jewing18/Automated-Chicken-Coop-wifi-enabled/Setup, Info/Example of Door Motor.png

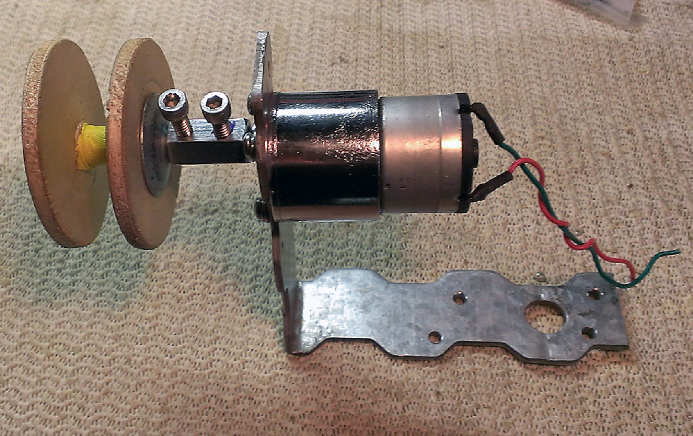
Setup, Info/Example of Door Motor.png
