jewing18/Automated-Chicken-Coop-wifi-enabled/Setup, Info/Wiring Diagram.png

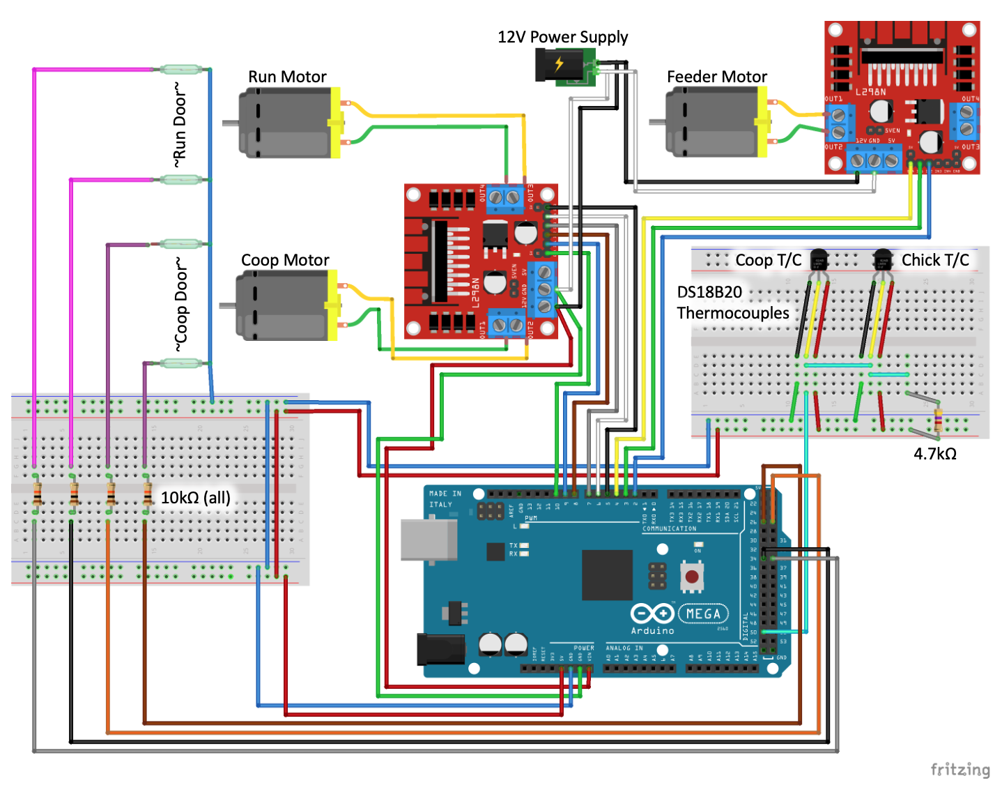
Setup, Info/Wiring Diagram.png
