jewing18/Automated-Chicken-Coop-wifi-enabled/STLs/Door Motor Mounts_REV00 v1.step

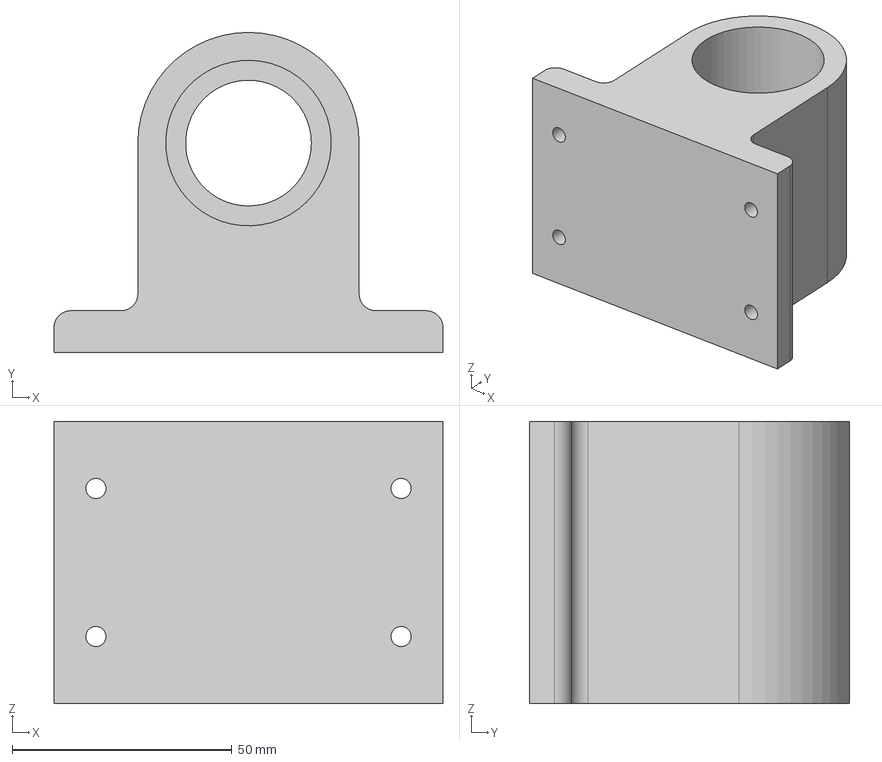
[picture p3: CAD file, 2022-02-02]
STLs/Door Motor Mounts_REV00 v1.step
88.4 x 72.8 x 64.1 mm
