jewing18/Automated-Chicken-Coop-wifi-enabled/STLs/Door Pulley_REV00 v1.step

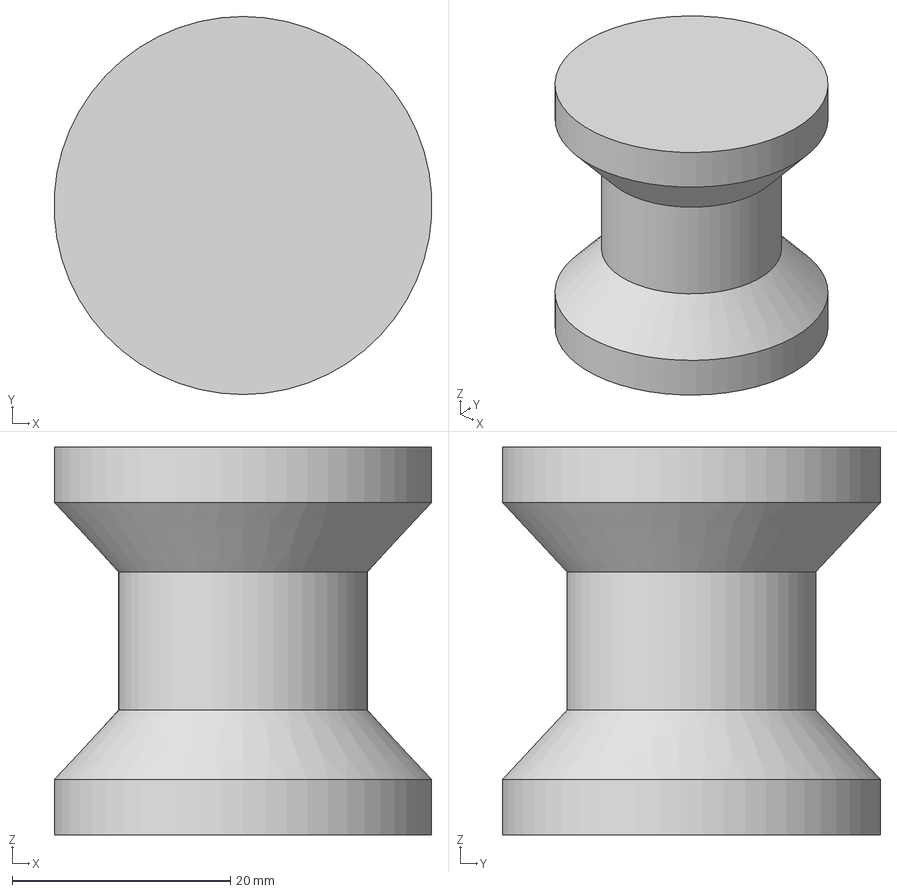
[picture p4: CAD file, 2022-02-02]
STLs/Door Pulley_REV00 v1.step
34.6 x 34.7 x 35.6 mm
