jewing18/Automated-Chicken-Coop-wifi-enabled/STLs/Feed Screw_REV00 v2.step

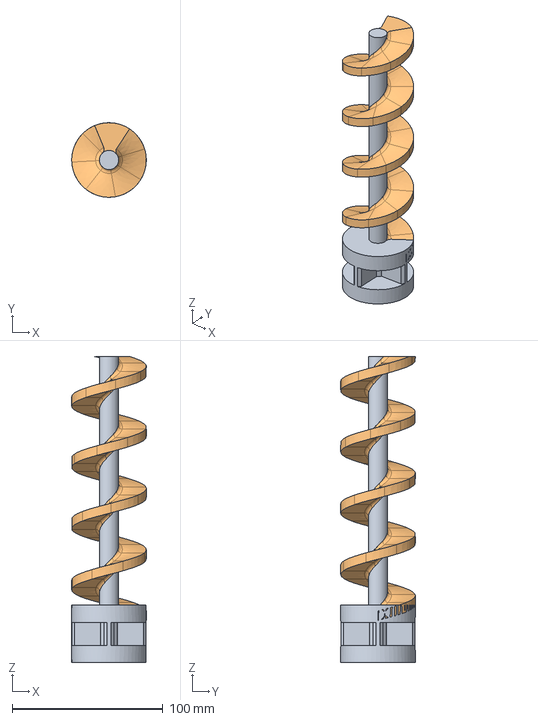
[picture p5: CAD file, 2022-02-02]
STLs/Feed Screw_REV00 v2.step
49.5 x 49.5 x 203.2 mm
