jewing18/Automated-Chicken-Coop-wifi-enabled/Setup, Info/Blynk_Datastream_Setup.png

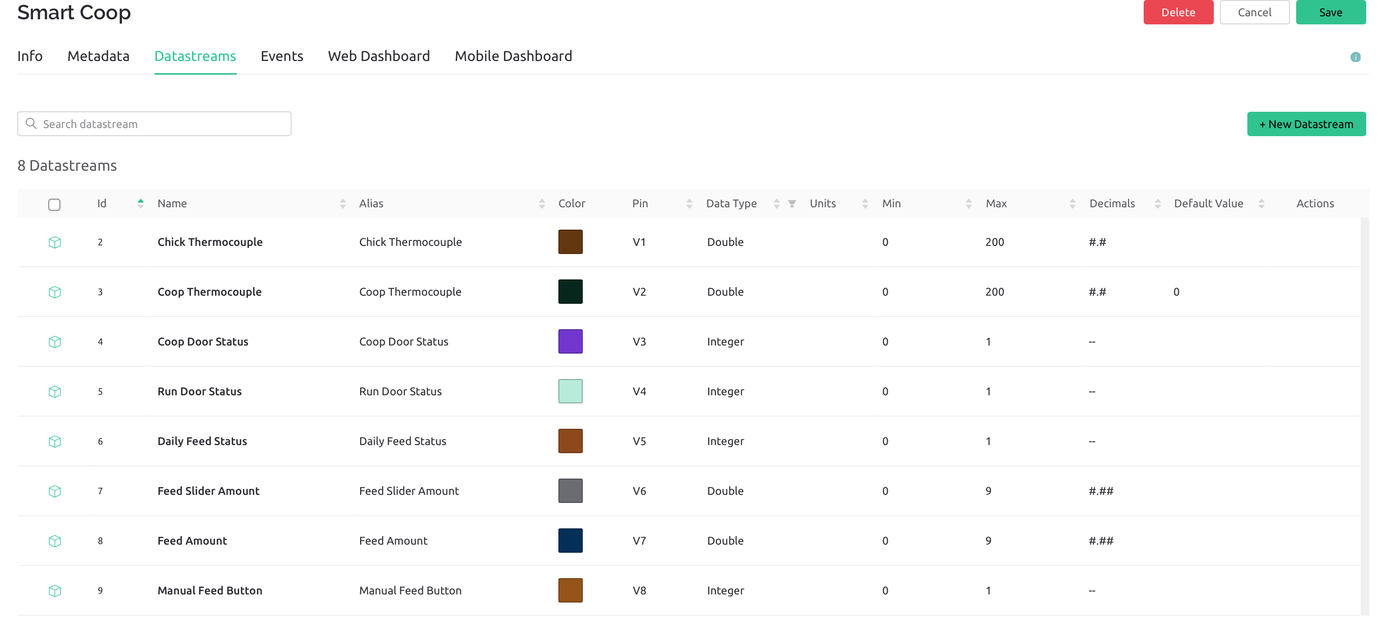
Setup, Info/Blynk_Datastream_Setup.png
