jewing18/Automated-Chicken-Coop-wifi-enabled/Setup, Info/DIP Switch Config CHart.png

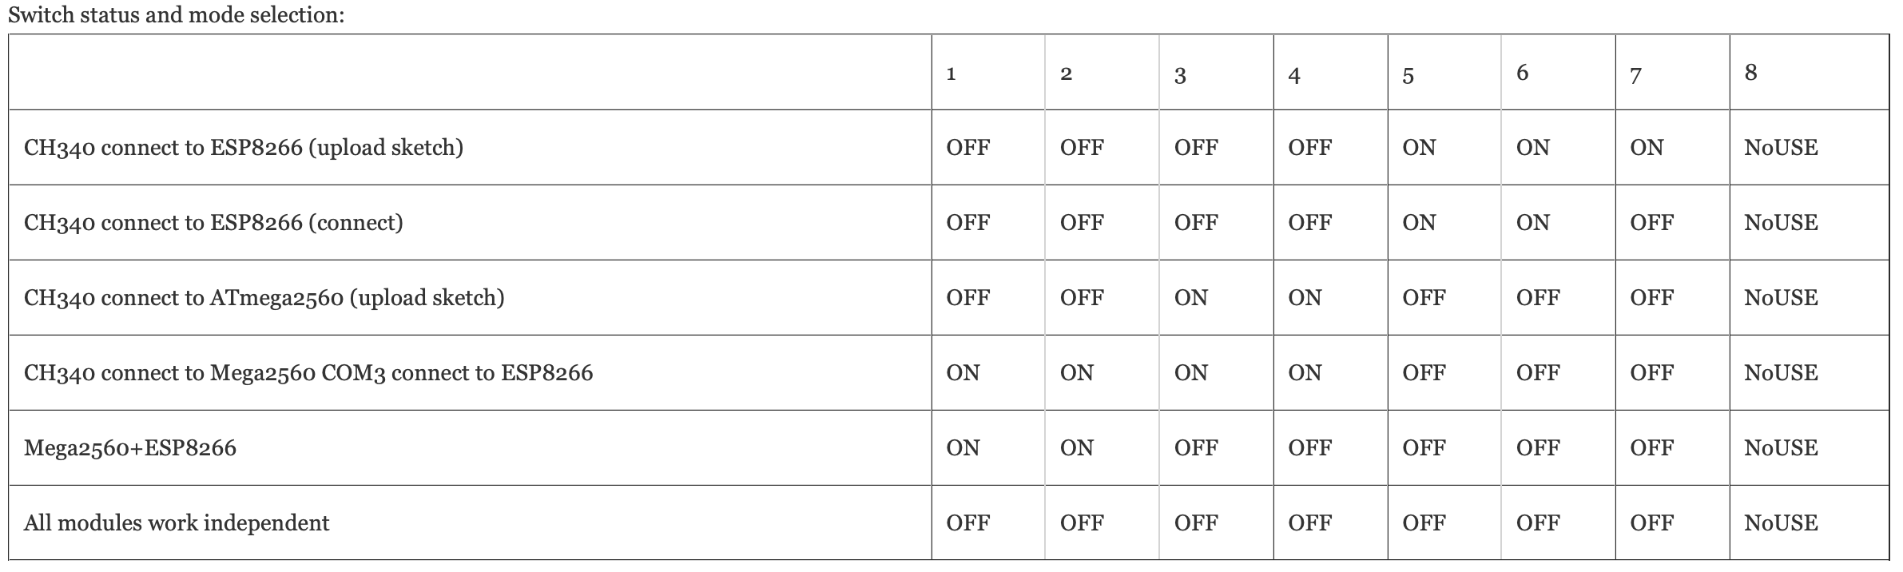
Setup, Info/DIP Switch Config CHart.png
